mark-bobot/bionic-phoenix-hand/step/assembly_left.step

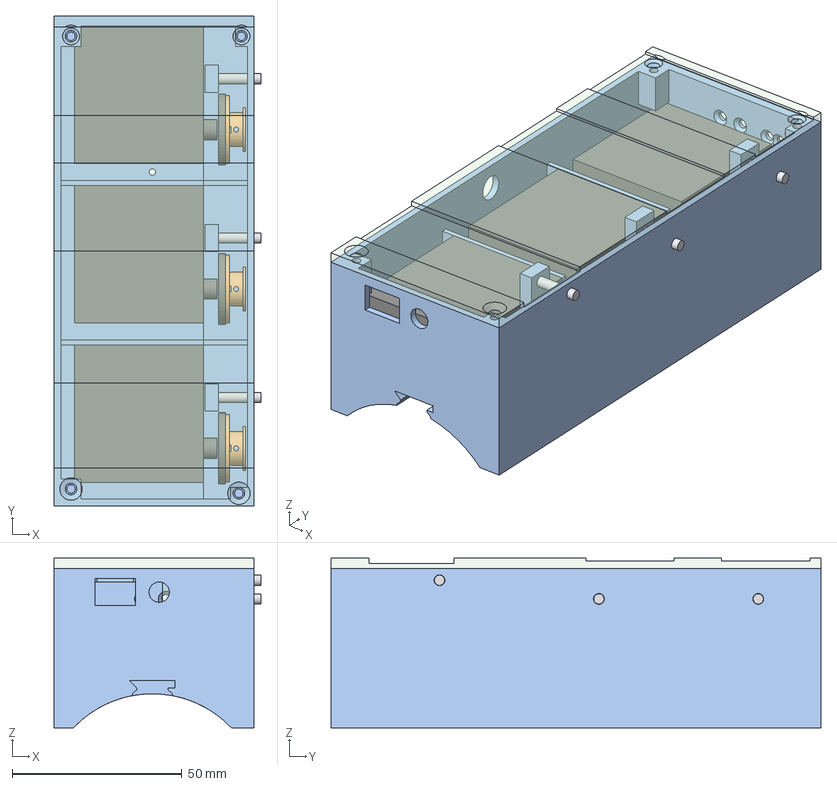
[picture p2: CAD file, 2026-10-15]
step/assembly_left.step
61.0 x 144.5 x 50.0 mm
base
lid
servo1_mockup
spool1
riser_pin1
servo2_mockup
spool2
riser_pin2
servo3_mockup
spool3
riser_pin3
