mark-bobot/bionic-phoenix-hand/stl/base_right.stl

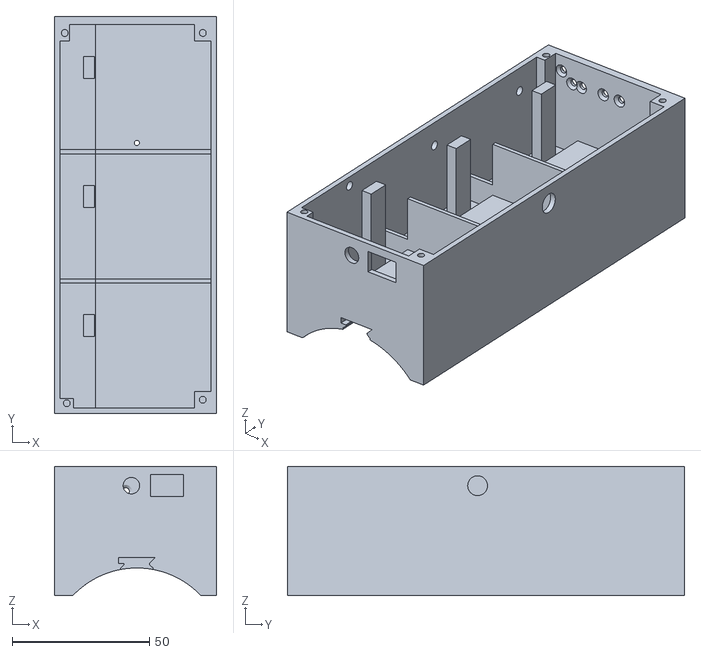
[picture p3: CAD file, 2026-10-15]
stl/base_right.stl
59.0 x 144.5 x 47.0
