mark-bobot/bionic-phoenix-hand/stl/lid_left.stl

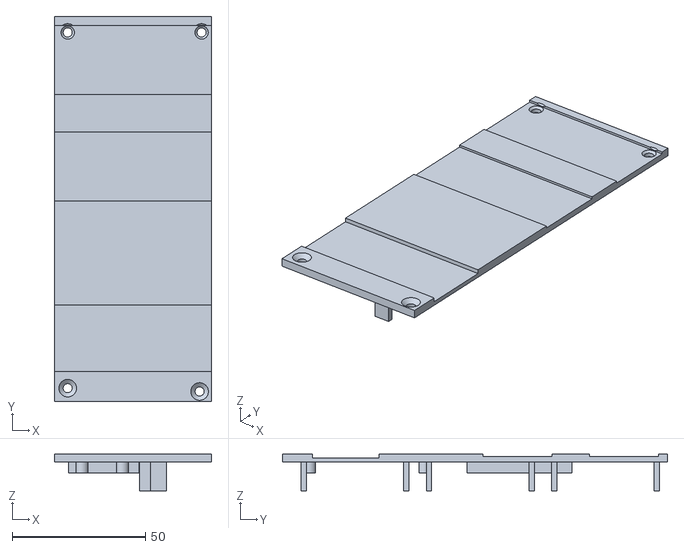
[picture p4: CAD file, 2026-10-15]
stl/lid_left.stl
59.0 x 144.5 x 13.7
