mark-bobot/bionic-phoenix-hand/stl/spool.stl

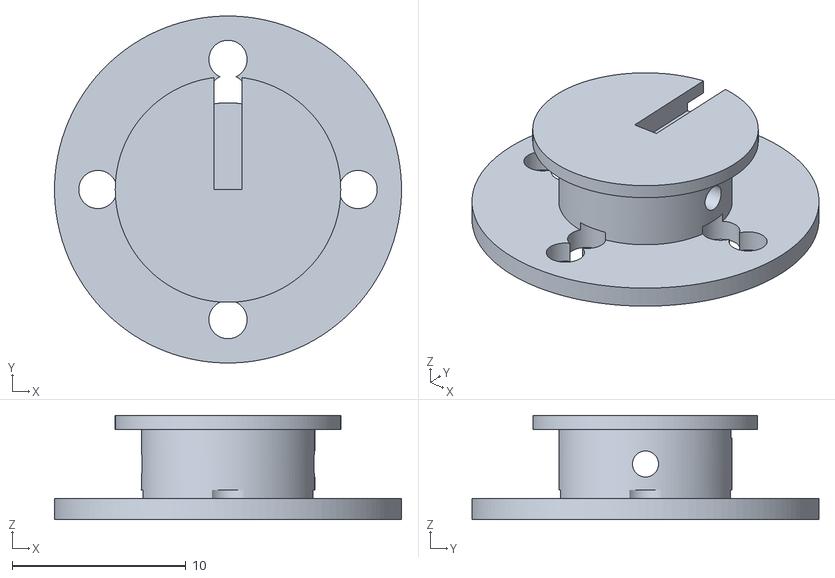
[picture p5: CAD file, 2026-10-15]
stl/spool.stl
20.0 x 20.0 x 6.00
