mark-bobot/bionic-phoenix-hand/stl/emg_backer.stl

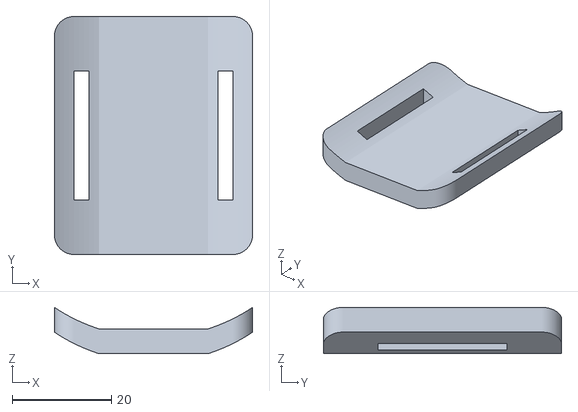
[picture p6: CAD file, 2026-10-15]
stl/emg_backer.stl
40.0 x 48.0 x 9.35
