mark-bobot/bionic-phoenix-hand/(list of files, cad)

Other CAD files:
step/assembly_right.step
stl/base_left.stl
stl/lid_right.stl
