mark-bobot/bionic-phoenix-hand/(commit log)

2026-10-15 Servo module for the Phoenix v3 hand
    [assembly_left.step, assembly_right.step, base_left.stl, base_right.stl, emg_backer.stl, lid_left.stl, lid_right.stl, spool.stl]
2026-10-15 Wire channel for the servo leads
    [assembly_left.step, assembly_right.step, base_left.stl, base_right.stl, lid_left.stl, lid_right.stl]
